XasWorks/dragon-home/README.md

# dragon-home
A rework of our old SmartHome project, this time done cleanly and neatly~
