XasWorks/dragon-home/Hardware/dragon-cookie/Main holding frame.stl

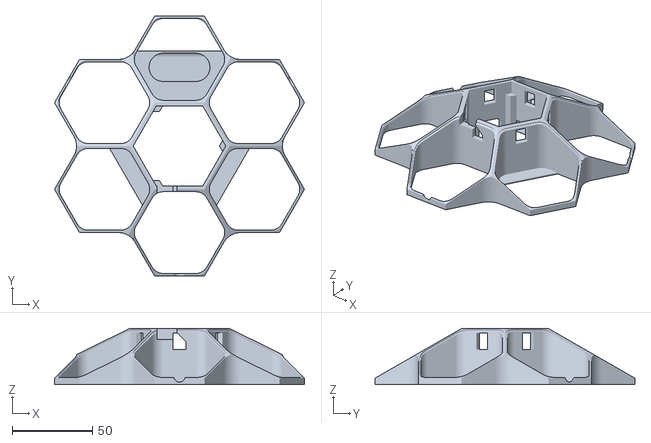
[picture p1: CAD file, 2021-05-06]
Hardware/dragon-cookie/Main holding frame.stl
155.9 x 162.0 x 35.0
