XasWorks/dragon-home/Hardware/dragon-cookie/Profile_Strain_Relief.FCStd

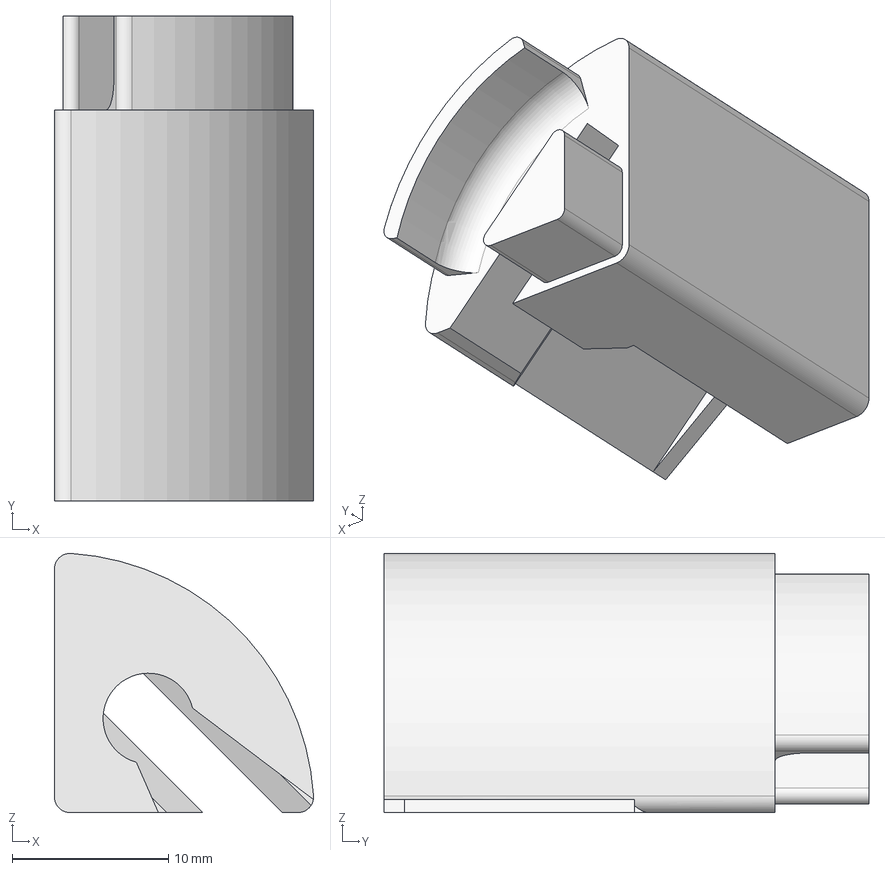
[picture p2: CAD file, 2021-08-22]
Hardware/dragon-cookie/Profile_Strain_Relief.FCStd
16.6 x 31.0 x 16.6 mm
