XasWorks/dragon-home/Hardware/dragon-diffuser/Diffuser.FCStd

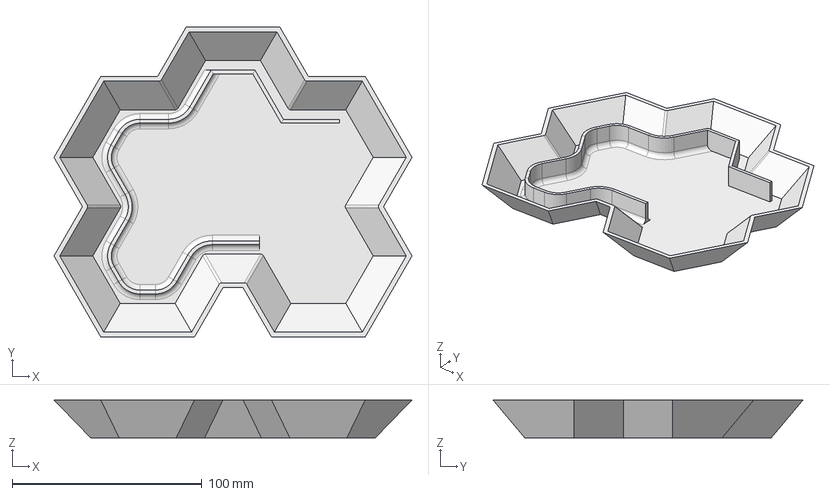
[picture p3: CAD file, 2021-08-30]
Hardware/dragon-diffuser/Diffuser.FCStd
188.8 x 163.5 x 20.0 mm
