XasWorks/dragon-home/Hardware/LED_Profile_MountClips.FCStd

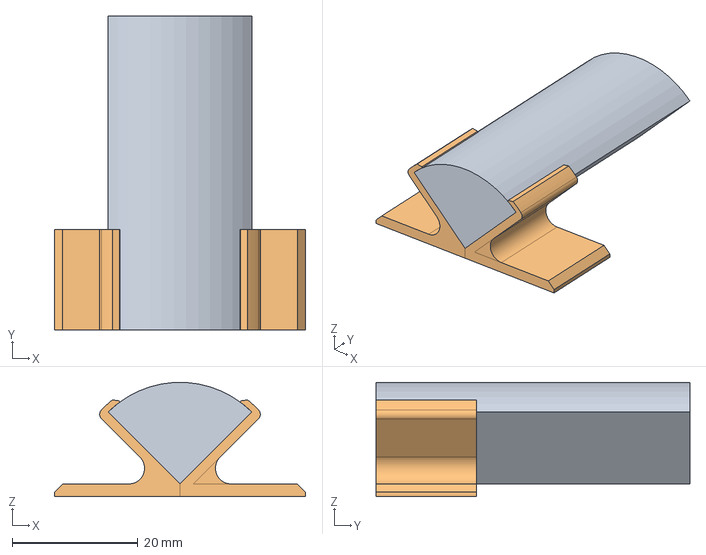
[picture p4: CAD file, 2024-07-04]
Hardware/LED_Profile_MountClips.FCStd
40.0 x 50.0 x 18.2 mm
