XasWorks/dragon-home/Hardware/dragon-cookie/Top Covers.stl

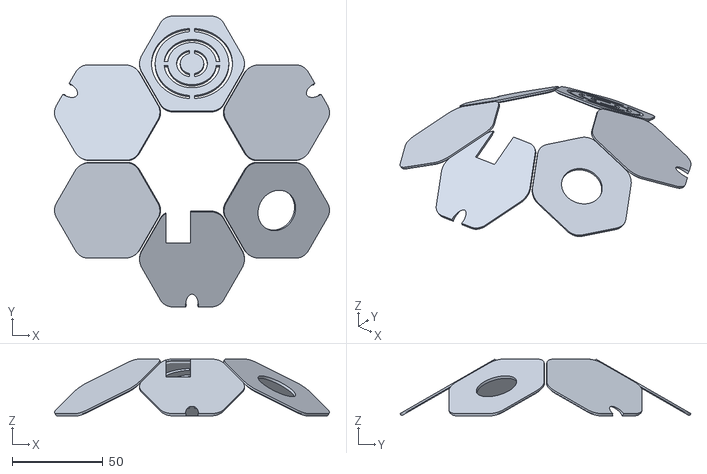
[picture p5: CAD file, 2021-05-06]
Hardware/dragon-cookie/Top Covers.stl
151.6 x 160.4 x 31.4
