XasWorks/dragon-home/Hardware/dragon-cookie/cookie-hex-mount.FCStd

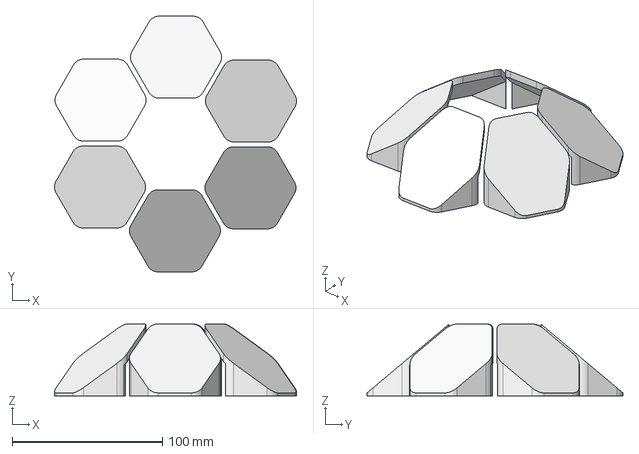
[picture p6: CAD file, 2021-03-07]
Hardware/dragon-cookie/cookie-hex-mount.FCStd
161.1 x 170.3 x 47.9 mm
