XasWorks/dragon-home/Hardware/dragon-cookie/KiCAD_Board.step

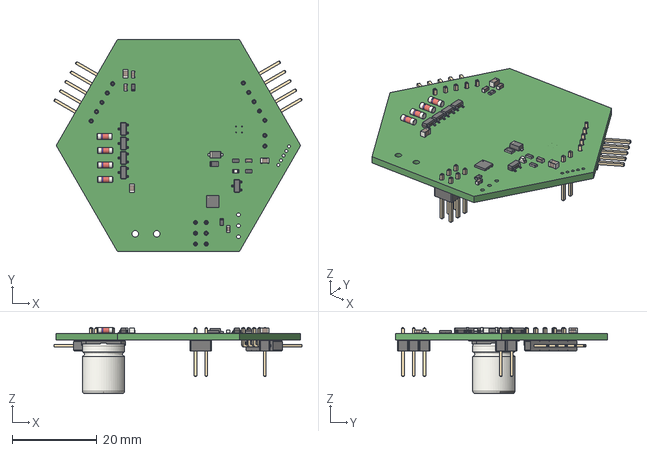
[picture p7: CAD file, 2021-03-07]
Hardware/dragon-cookie/KiCAD_Board.step
58.6 x 50.0 x 15.7 mm
