XasWorks/dragon-home/Hardware/dragon-cookie/BoardOutline.dxf

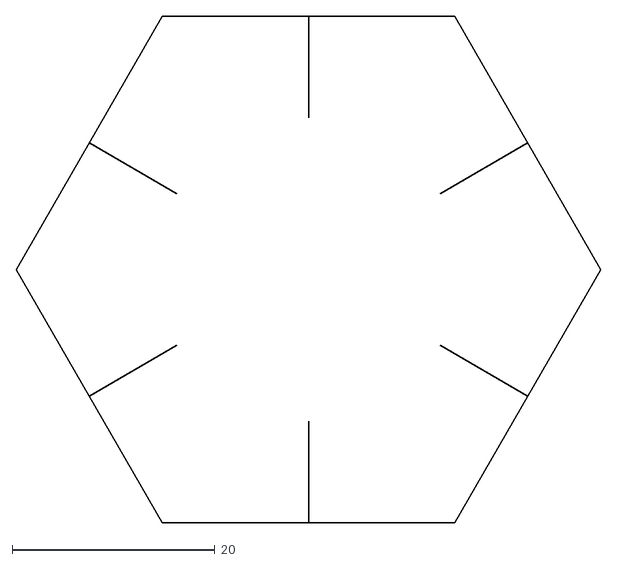
[picture p8: CAD file, 2021-02-09]
Hardware/dragon-cookie/BoardOutline.dxf
57.7 x 50.0
