XasWorks/dragon-home/Hardware/dragon-cookie/TestDrawing.dxf

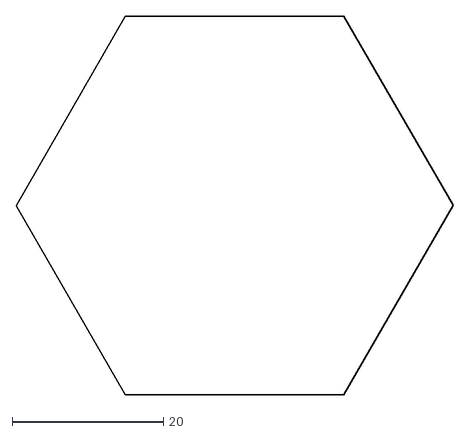
[picture p9: CAD file, 2021-02-09]
Hardware/dragon-cookie/TestDrawing.dxf
57.7 x 50.0
