XasWorks/dragon-home/Hardware/dragon-cookie/cookie-mount.FCStd

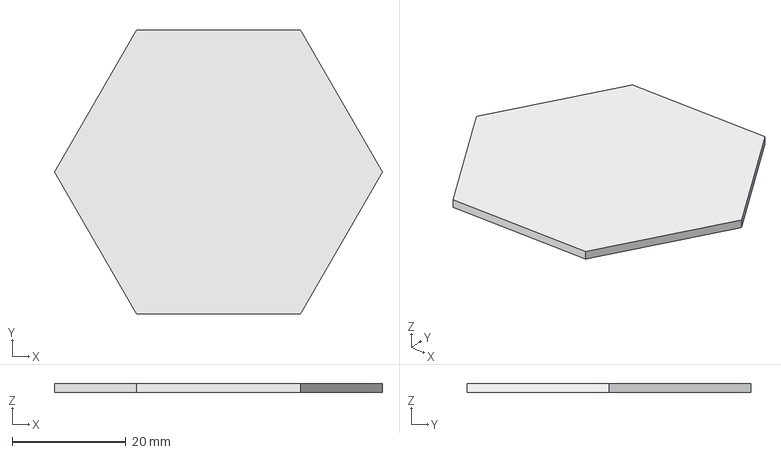
[picture p10: CAD file, 2021-02-09]
Hardware/dragon-cookie/cookie-mount.FCStd
57.7 x 50.0 x 1.50 mm
