XasWorks/dragon-home/(list of files, cad)

Other CAD files:
Hardware/dragon-cookie/Profile_Strain_Relief-Body003.step
Hardware/LED_Profile_MountClips.stl
Hardware/dragon-cookie/Profile_Strain_Relief-Body003.stl
