XasWorks/dragon-home/Hardware/dragon-cookie/KiCAD_Board/KiCAD_Board.kicad_pcb

## KiCad design Hardware/dragon-cookie/KiCAD_Board/KiCAD_Board.kicad_pcb (2021-02-26)

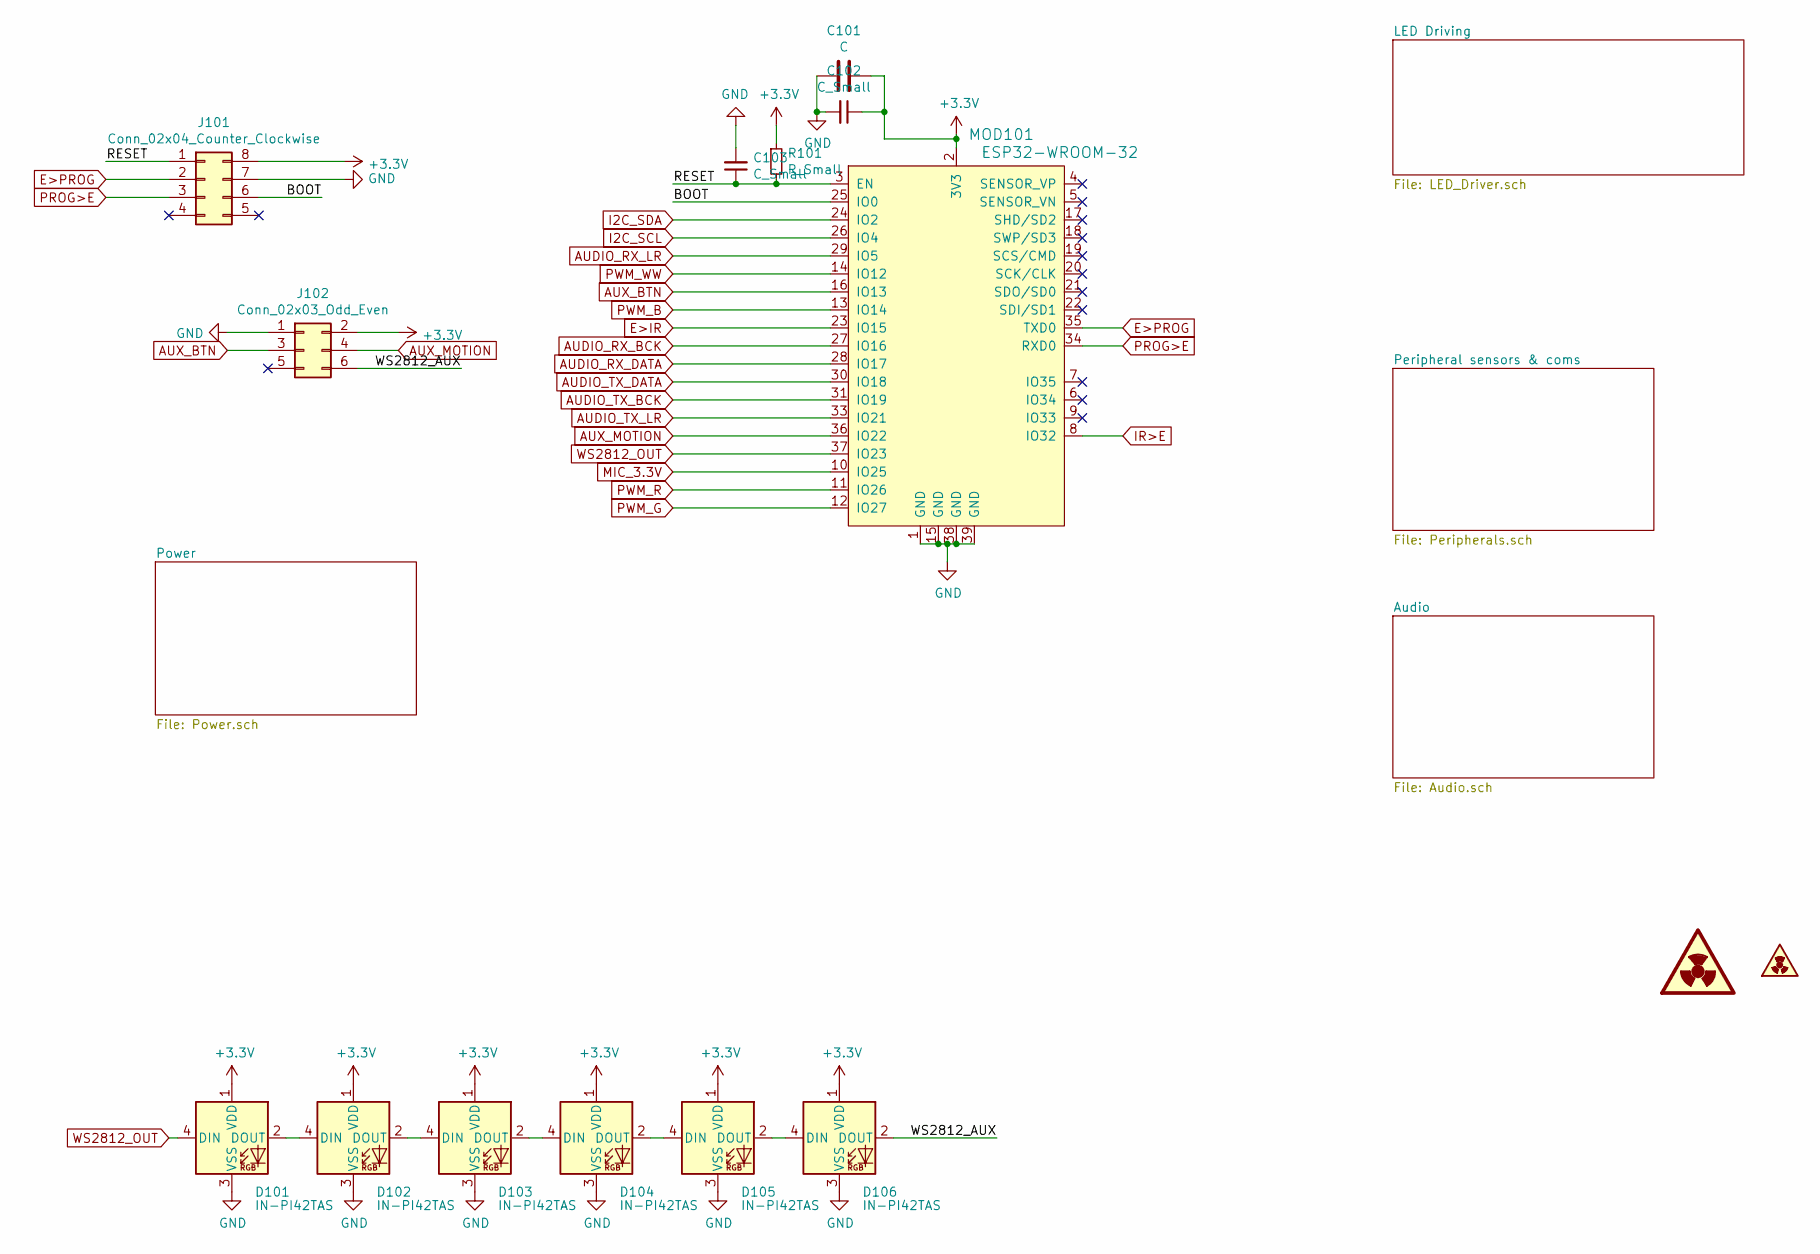
[picture p11: schematic KiCAD_Board.sch]

Parts:
C101: C; C_0805_2012Metric
C102, C103: C_Small; C_0603_1608Metric
D101, D102, D103, D104, D105, D106: IN-PI42TAS
J101: Conn_02x04_Counter_Clockwise; SOIC_clipProgSmall
J102: Conn_02x03_Odd_Even; PinHeader_2x03_P2.54mm_Vertical
MOD101: ESP32-WROOM-32; ESP32-WROOM-32D; MPN ESP32-WROOM-32; Digi-Key_PN 1904-1010-1-ND
R101: R_Small; R_0603_1608Metric
SYM101: SYM_Radioactive_Radiation_Small; DragonIcon_25mm
SYM102: SYM_Radioactive_Large; OSHW-Logo2_7.3x6mm_SilkScreen

Connections:
+3V3: C101.1, C102.1, D101.1 (VDD), D102.1 (VDD), D103.1 (VDD), D104.1 (VDD), D105.1 (VDD), D106.1 (VDD), J101.8, J102.2, MOD101.2 (3V3), R101.1; also elsewhere on the board
/BOOT: J101.6, MOD101.25 (IO0)
/RESET: C103.1, J101.1, MOD101.3 (EN), R101.2
/WS2812_AUX: D106.2 (DOUT), J102.6
AUDIO_RX_BCK: MOD101.27 (IO16); also elsewhere on the board
AUDIO_RX_DATA: MOD101.28 (IO17); also elsewhere on the board
AUDIO_RX_LR: MOD101.29 (IO5); also elsewhere on the board
AUDIO_TX_BCK: MOD101.31 (IO19); also elsewhere on the board
AUDIO_TX_DATA: MOD101.30 (IO18); also elsewhere on the board
AUDIO_TX_LR: MOD101.33 (IO21); also elsewhere on the board
AUX_BTN: J102.3, MOD101.16 (IO13)
AUX_MOTION: J102.4, MOD101.36 (IO22)
E>IR: MOD101.23 (IO15); also elsewhere on the board
E>PROG: J101.2, MOD101.35 (TXD0)
GND: C101.2, C102.2, C103.2, D101.3 (VSS), D102.3 (VSS), D103.3 (VSS), D104.3 (VSS), D105.3 (VSS), D106.3 (VSS), J101.7, J102.1, MOD101.1 (GND), MOD101.15 (GND), MOD101.38 (GND), MOD101.39 (GND); also elsewhere on the board
I2C_SCL: MOD101.26 (IO4); also elsewhere on the board
I2C_SDA: MOD101.24 (IO2); also elsewhere on the board
IR>E: MOD101.8 (IO32); also elsewhere on the board
MIC_3.3V: MOD101.10 (IO25); also elsewhere on the board
unnamed: D101.2 (DOUT), D102.4 (DIN)
unnamed: D102.2 (DOUT), D103.4 (DIN)
unnamed: D103.2 (DOUT), D104.4 (DIN)
unnamed: D104.2 (DOUT), D105.4 (DIN)
unnamed: D105.2 (DOUT), D106.4 (DIN)
PROG>E: J101.3, MOD101.34 (RXD0)
PWM_B: MOD101.13 (IO14); also elsewhere on the board
PWM_G: MOD101.12 (IO27); also elsewhere on the board
PWM_R: MOD101.11 (IO26); also elsewhere on the board
PWM_WW: MOD101.14 (IO12); also elsewhere on the board
WS2812_OUT: D101.4 (DIN), MOD101.37 (IO23)

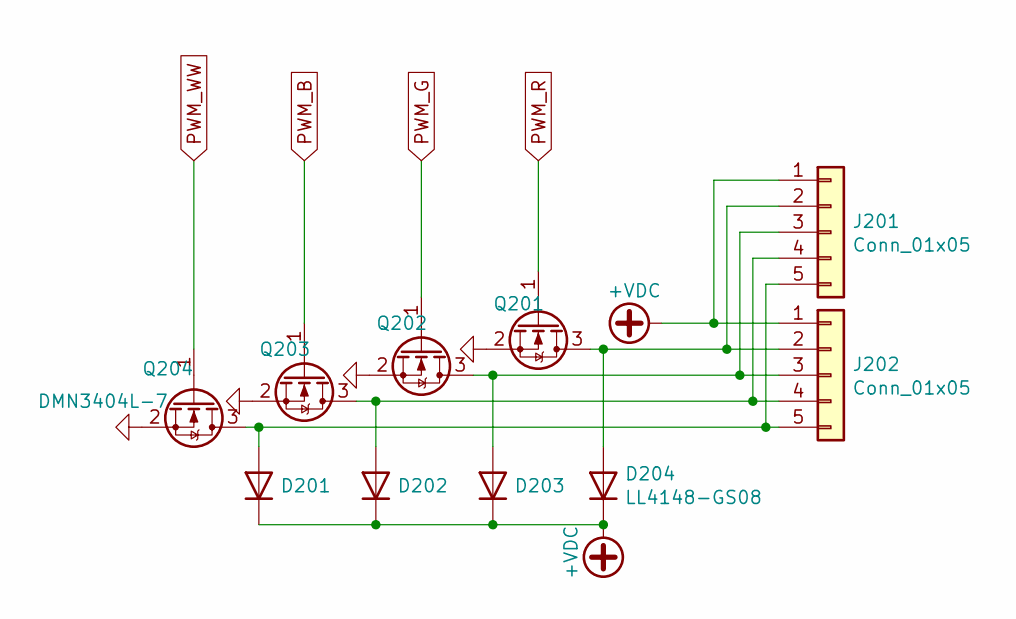
[picture p12: schematic LED_Driver.sch]

Parts:
D201, D202, D203, D204: LL4148-GS08; D_MiniMELF
J201, J202: Conn_01x05; PinHeader_1x05_P2.54mm_Horizontal
Q201, Q202, Q203, Q204: DMN3404L-7; SOT-23

Connections:
+VDC: D201.1 (K), D202.1 (K), D203.1 (K), D204.1 (K), J201.1, J202.1; also elsewhere on the board
GND: Q201.2 (S), Q202.2 (S), Q203.2 (S), Q204.2 (S); also elsewhere on the board
unnamed: D201.2 (A), J201.5, J202.5, Q204.3 (D)
unnamed: D202.2 (A), J201.4, J202.4, Q203.3 (D)
unnamed: D203.2 (A), J201.3, J202.3, Q202.3 (D)
unnamed: D204.2 (A), J201.2, J202.2, Q201.3 (D)
PWM_B: Q203.1 (G); also elsewhere on the board
PWM_G: Q202.1 (G); also elsewhere on the board
PWM_R: Q201.1 (G); also elsewhere on the board
PWM_WW: Q204.1 (G); also elsewhere on the board

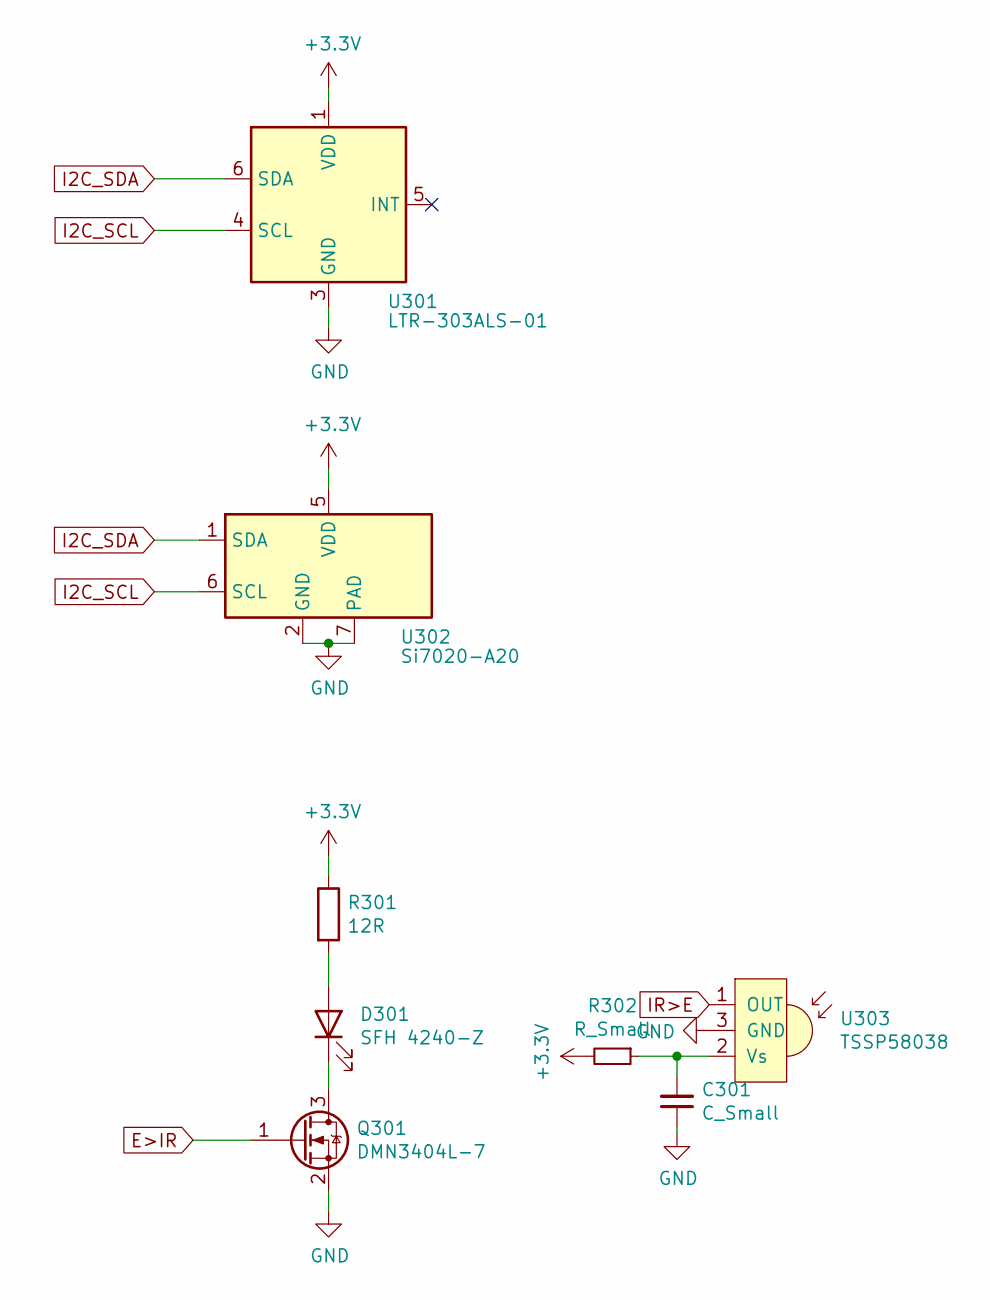
[picture p13: schematic Peripherals.sch]

Parts:
C301: C_Small; C_0603_1608Metric
D301: SFH 4240-Z; SFH 4240
Q301: DMN3404L-7; SOT-23
R301: 12R; R_0805_2012Metric
R302: R_Small; R_0603_1608Metric
U301: LTR-303ALS-01; Lite-On_LTR-303ALS-01
U302: Si7020-A20; DFN-6-1EP_3x3mm_P1mm_EP1.5x2.4mm
U303: TSSP58038; TO-92-3_Formed_Leads; MPN TSOP322...; Digi-Key_PN TSSP58038-ND

Connections:
+3V3: R301.1, R302.2, U301.1 (VDD), U302.5 (VDD); also elsewhere on the board
E>IR: Q301.1 (G); also elsewhere on the board
GND: C301.1, Q301.2 (S), U301.3 (GND), U302.2 (GND), U302.7 (PAD), U303.3 (GND); also elsewhere on the board
I2C_SCL: U301.4 (SCL), U302.6 (SCL); also elsewhere on the board
I2C_SDA: U301.6 (SDA), U302.1 (SDA); also elsewhere on the board
IR>E: U303.1 (OUT); also elsewhere on the board
unnamed: C301.2, R302.1, U303.2 (Vs)
unnamed: D301.1 (K), Q301.3 (D)
unnamed: D301.2 (A), R301.2

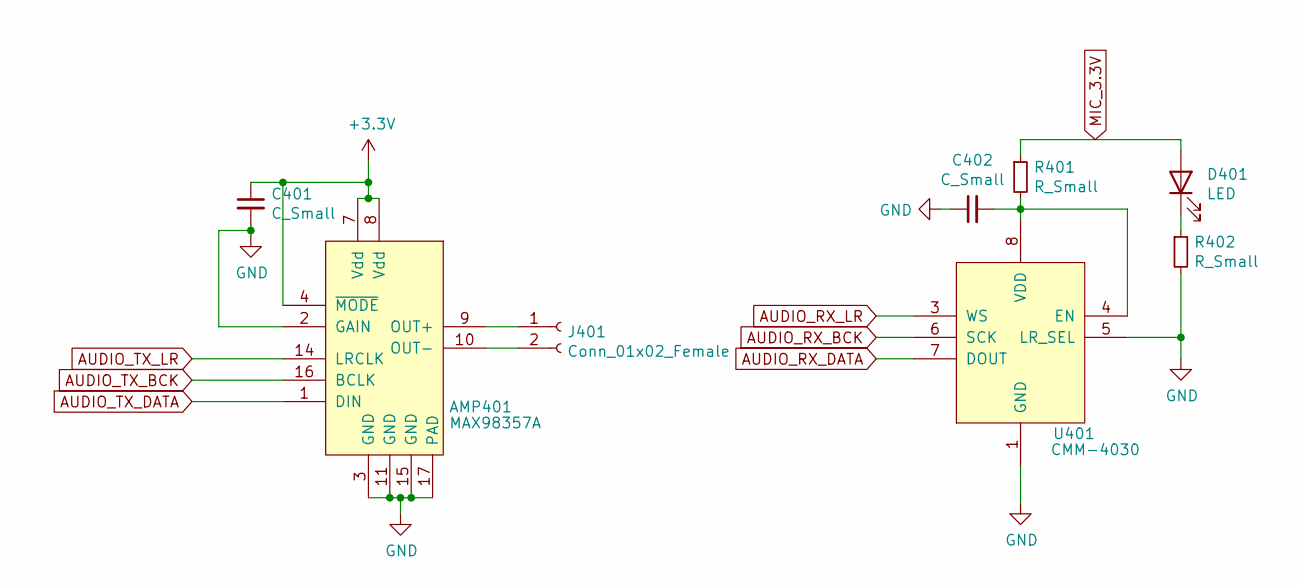
[picture p14: schematic Audio.sch]

Parts:
AMP401: MAX98357A; QFN-16-1EP_3x3mm_P0.5mm_EP1.9x1.9mm_ThermalVias
C401: C_Small; C_0805_2012Metric
C402: C_Small; C_0603_1608Metric
D401: LED; LED_0603_1608Metric
J401: Conn_01x02_Female; PinHeader_1x02_P2.54mm_Vertical
R401, R402: R_Small; R_0603_1608Metric
U401: CMM-4030; DigiKey_PN 2223-CMM-4030D-261-I2S-CT-ND

Connections:
+3V3: AMP401.4 (~MODE), AMP401.7 (Vdd), AMP401.8 (Vdd), C401.1; also elsewhere on the board
AUDIO_RX_BCK: U401.6 (SCK); also elsewhere on the board
AUDIO_RX_DATA: U401.7 (DOUT); also elsewhere on the board
AUDIO_RX_LR: U401.3 (WS); also elsewhere on the board
AUDIO_TX_BCK: AMP401.16 (BCLK); also elsewhere on the board
AUDIO_TX_DATA: AMP401.1 (DIN); also elsewhere on the board
AUDIO_TX_LR: AMP401.14 (LRCLK); also elsewhere on the board
GND: AMP401.2 (GAIN), AMP401.3 (GND), AMP401.11 (GND), AMP401.15 (GND), AMP401.17 (PAD), C401.2, C402.1, R402.2, U401.1 (GND), U401.5 (LR_SEL); also elsewhere on the board
MIC_3.3V: D401.2 (A), R401.1; also elsewhere on the board
unnamed: AMP401.9 (OUT+), J401.1
unnamed: AMP401.10 (OUT-), J401.2
unnamed: C402.2, R401.2, U401.4 (EN), U401.8 (VDD)
unnamed: D401.1 (K), R402.1

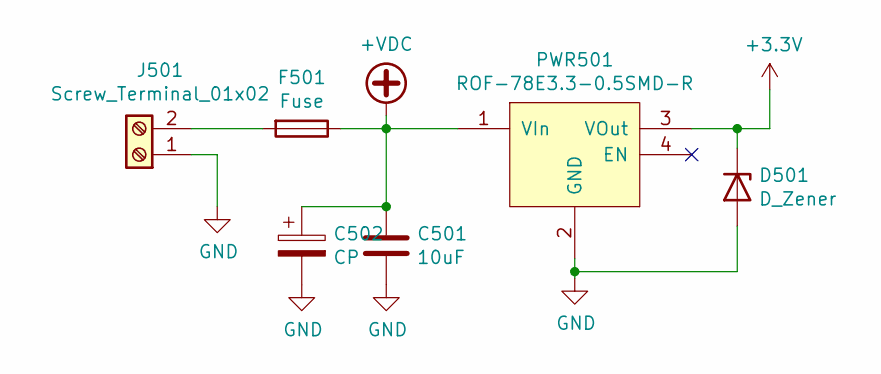
[picture p15: schematic Power.sch]

Parts:
C501: 10uF; C_0805_2012Metric
C502: CP; CP_Elec_10x12.6
D501: D_Zener; D_SOD-123F
F501: Fuse; Fuse_1210_3225Metric_Castellated
J501: Screw_Terminal_01x02; TerminalBlock_bornier-2_P5.08mm
PWR501: ROF-78E3.3-0.5SMD-R; ROF-78E; DigiKey_PN 945-1689-1-ND

Connections:
+3V3: D501.1 (K), PWR501.3 (VOut); also elsewhere on the board
+VDC: C501.1, C502.1, F501.1, PWR501.1 (VIn); also elsewhere on the board
GND: C501.2, C502.2, D501.2 (A), J501.1, PWR501.2 (GND); also elsewhere on the board
unnamed: F501.2, J501.2

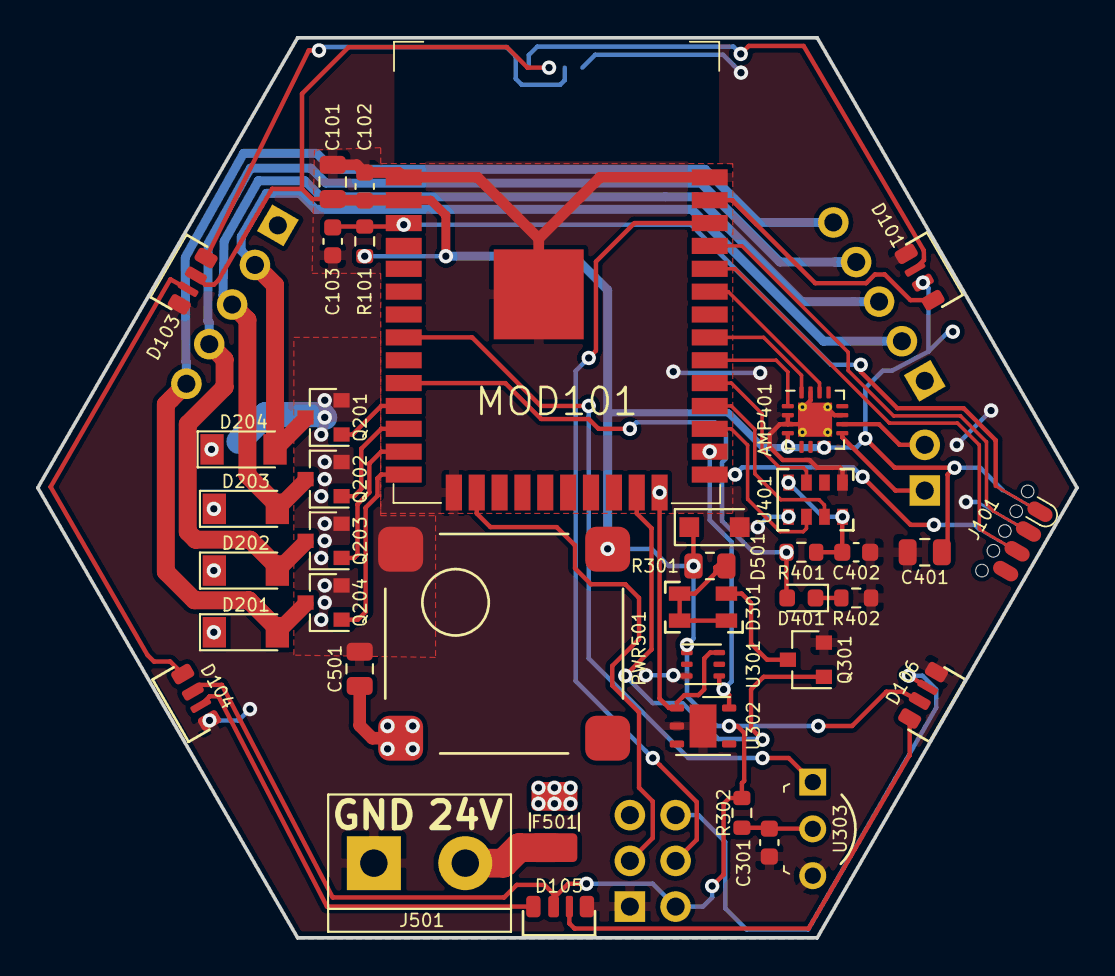
[picture p16: board KiCAD_Board.kicad_pcb from above]

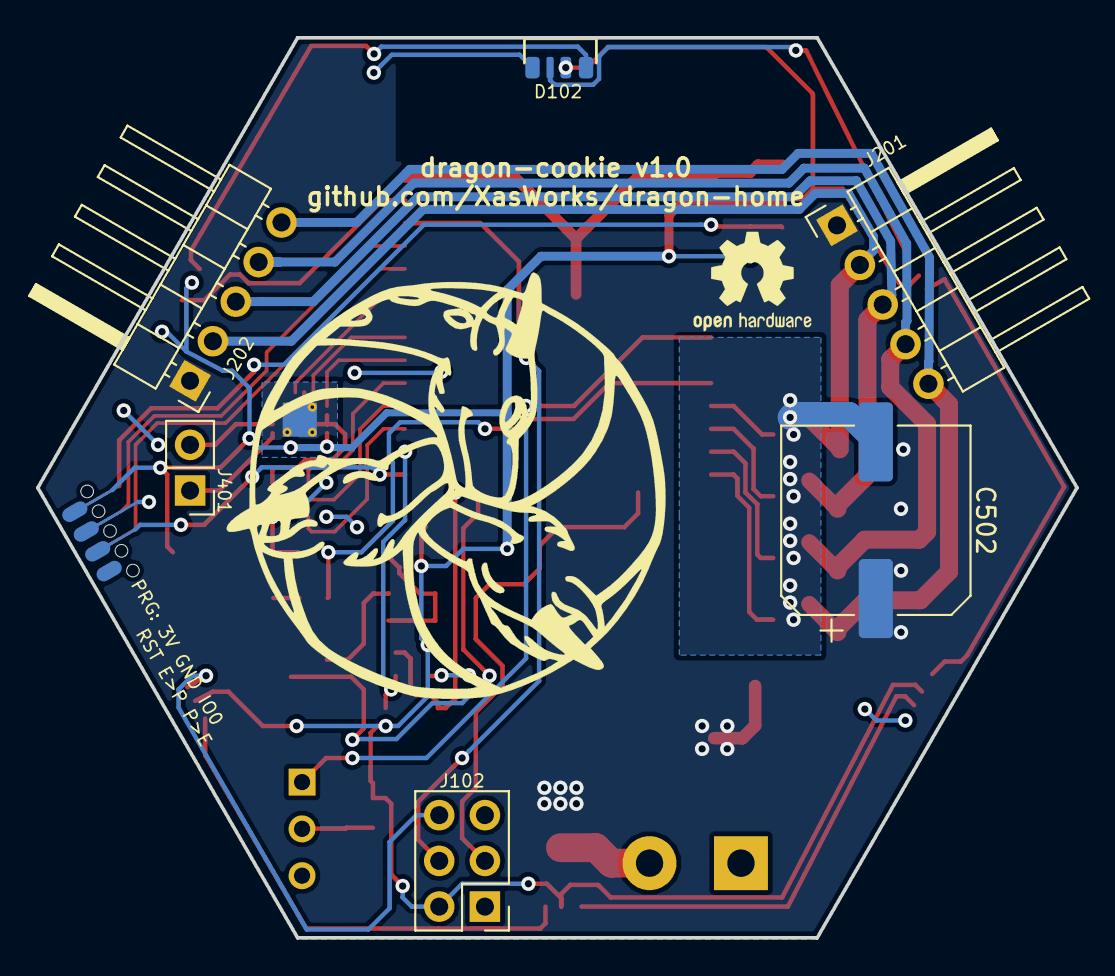
[picture p17: board KiCAD_Board.kicad_pcb from below]

Board: 2 copper layers, 57.7 x 50.0 mm, 47 parts (8 on the bottom side), 43 nets.
