XasWorks/dragon-home/(commit log)

2021-02-09 Add a few necessary footprints
2021-02-09 Start work on the first dragon cookie schematics
    [Audio.sch, BoardOutline.dxf, KiCAD_Board.kicad_pcb, KiCAD_Board.sch, LED_Driver.sch, Peripherals.sch, Power.sch, TestDrawing.dxf]
2021-02-26 Produce Gerbers for v1.0 of the dragon-cookie hardware
    [Audio.sch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]
2021-03-07 Continue work on the cookie mount
    [KiCAD_Board.step, cookie-hex-mount.FCStd]
2021-03-07 Nibble a bit more on the FCSTD Model
    [cookie-hex-mount.FCStd]
2021-03-17 Add a bunch of stuff
    [partitions.csv]
2021-03-17 Add updated mount
2021-05-06 Fix the 3D Models
    [Main holding frame.stl, Top Covers.stl]
2021-08-22 ... Y-Yes?
    [Profile_Strain_Relief-Body003.step, Profile_Strain_Relief-Body003.stl, Profile_Strain_Relief.FCStd]
2021-08-22 Update XasCode to track new BLE code
2021-08-30 Start tweaking the system to use just a tad less RAM
    [Diffuser.FCStd]
2021-08-30 Will this track master??
2021-09-09 Work on fixing the glitched OTA
    [connectivity.cpp, hw.cpp, hw.h, main.cpp]
2024-07-04 Not even sure what this is
    [LED_Profile_MountClips.FCStd, LED_Profile_MountClips.stl]
